Mahfuzur-rahman-tanvir131/smart-medicine-reminder/hardware/schematic-low-voltage.jpg

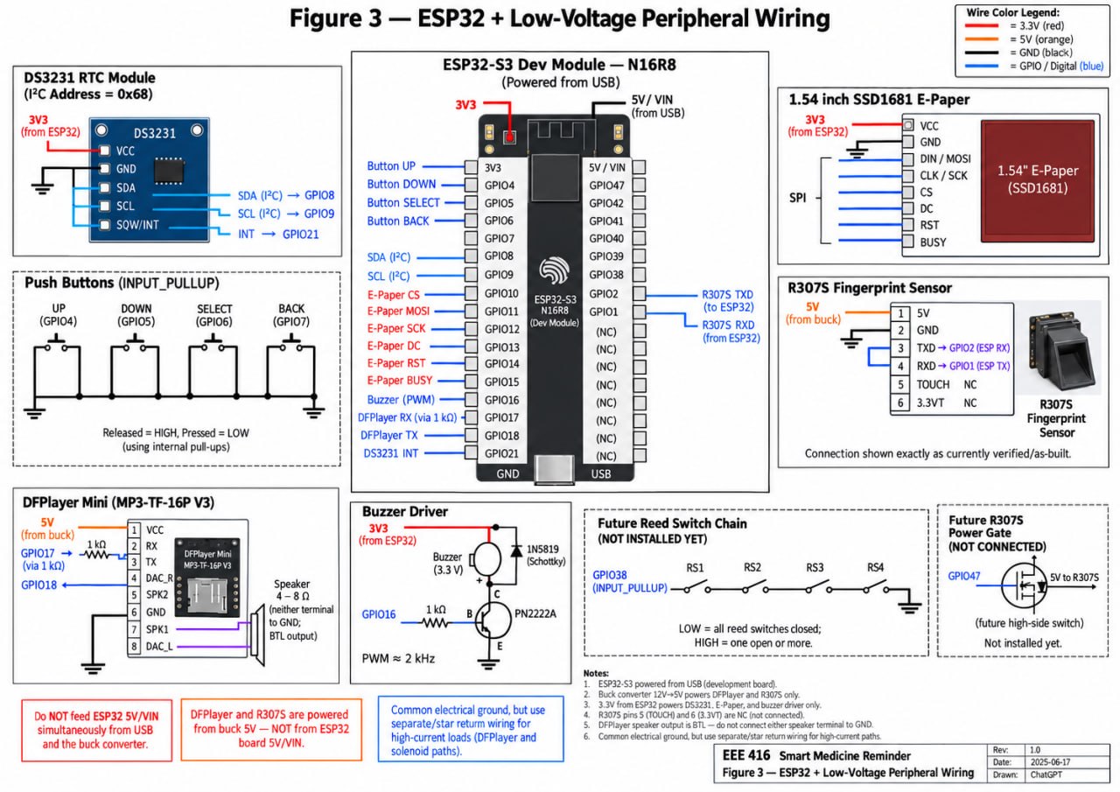
hardware/schematic-low-voltage.jpg
