Mahfuzur-rahman-tanvir131/smart-medicine-reminder/hardware/schematic-overview.jpg

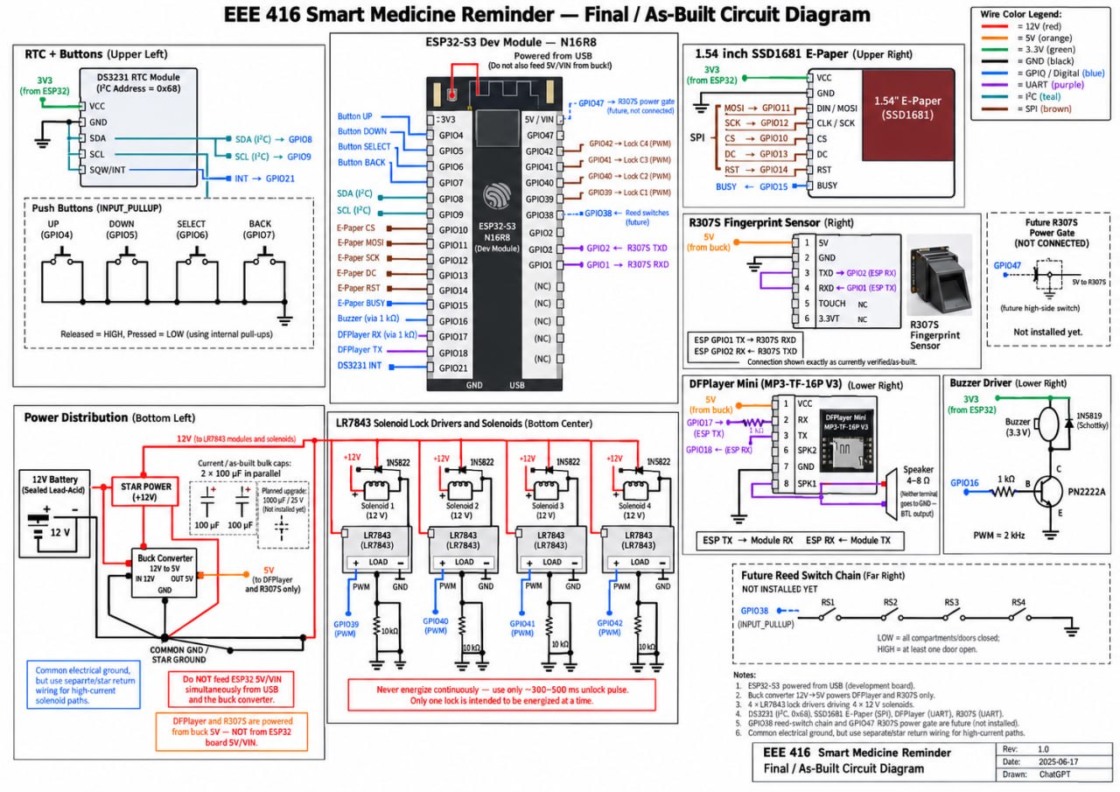
hardware/schematic-overview.jpg
