Mahfuzur-rahman-tanvir131/smart-medicine-reminder/hardware/schematic-power-locks.jpg

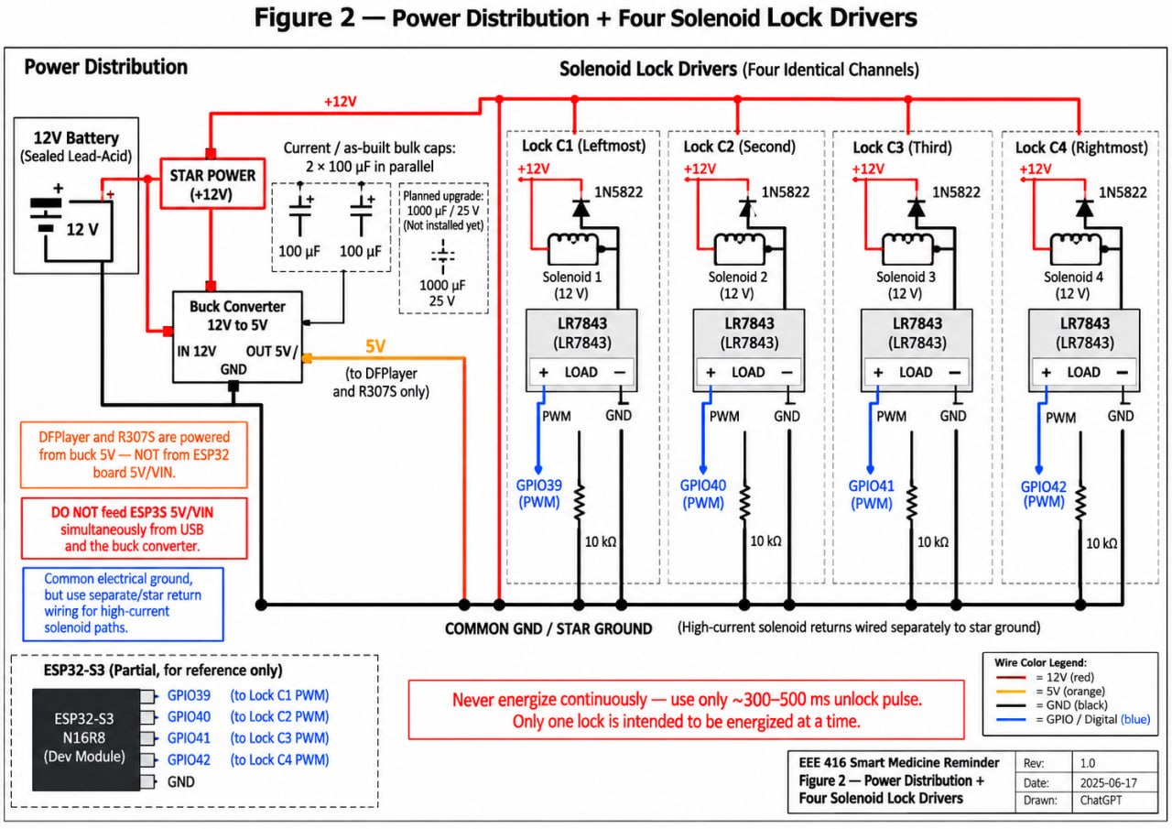
hardware/schematic-power-locks.jpg
