Mahfuzur-rahman-tanvir131/smart-medicine-reminder/(commit log)

2026-10-02 Smart Medicine Reminder — biometric pill box with a Bengali interface
    ESP32-S3 firmware for a four-compartment medicine box that unlocks only
    the scheduled compartment, and only for the fingerprint of the person
    that dose belongs to. Fully Bengali screen, voice and dashboard, and no
    dependency on a network for anything in the user's path.
    Includes the firmware, the pre-shaped Bengali rendering layer for
    e-paper, the voice prompts, PCB and schematics, and the user manual.
    EEE 416 Project, Department of EEE, BUET.
2026-10-02 Update README.md
    Removed a comma for improved sentence flow.
2026-10-02 README: summarise rather than narrate
    Cut the implementation and debugging detail - the nukta/NFC history, the
    JTAG pin note, the per-defect commentary - and left the summaries. The
    Bengali section now states the approach and the result instead of how it
    was arrived at.
2026-10-02 README: add power section, full pin map with fitted status, drop Scope
    The pin table now lists every GPIO individually with what it connects to
    and whether that hardware is actually installed, plus the pins that must
    be left alone on the N16R8 module. Added a Power section covering the
    sleep model and why each choice saves what it does.
2026-10-02 README: drop the pin map, let the schematics carry the wiring
2026-10-02 Replace the PCB 3D render with the updated board
